EveTheWizard/Swarm-Drones/20190329_122631(2).jpg

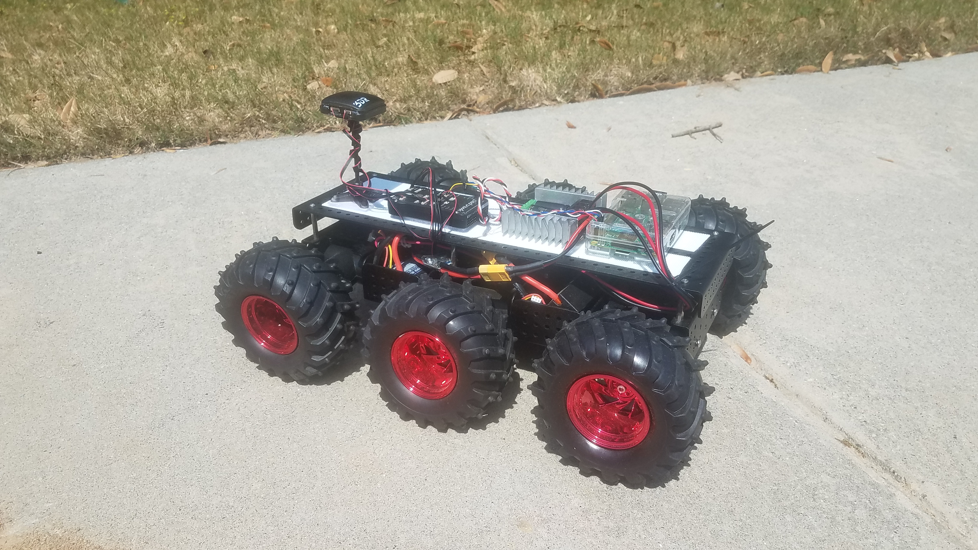
20190329_122631(2).jpg
