EveTheWizard/Swarm-Drones/20190407_185555.jpg

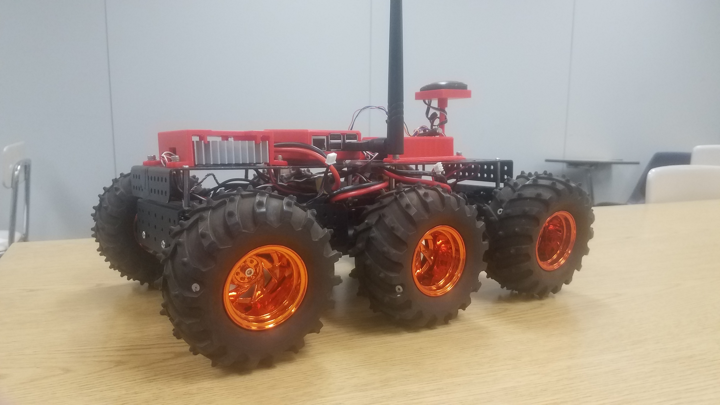
20190407_185555.jpg
