EveTheWizard/Swarm-Drones/README.md

# Swarm Drones
 A framework and prototype o a swarm drones system for controlling  a warm of land drones to go to a GPS location
