EveTheWizard/Swarm-Drones/Drawings/Circuit Diagram.docx

http://www.yolinux.com/TUTORIALS/images/Drones/Pixhawk-quadcopter-graphic-schematic.jpg
