EveTheWizard/Swarm-Drones/Drawings/Doc1.docx

Motor #2

Motor #4

Motor #6

Motor #5

Motor #3

Motor #1

On-Board CPU (Raspberry Pi 3)

Flight Controller (Pixhawk)

Power Module

Electronic Speed Controller and BEC

Switch

PPM Sum Receiver

Receiver

Transmitter

Li-Po Battery

Battery Sensor

GPS & Compass

Telemetry

Host Computer

Telemetry
