EveTheWizard/Swarm-Drones/CDR Presentation/Screenshot (2).png

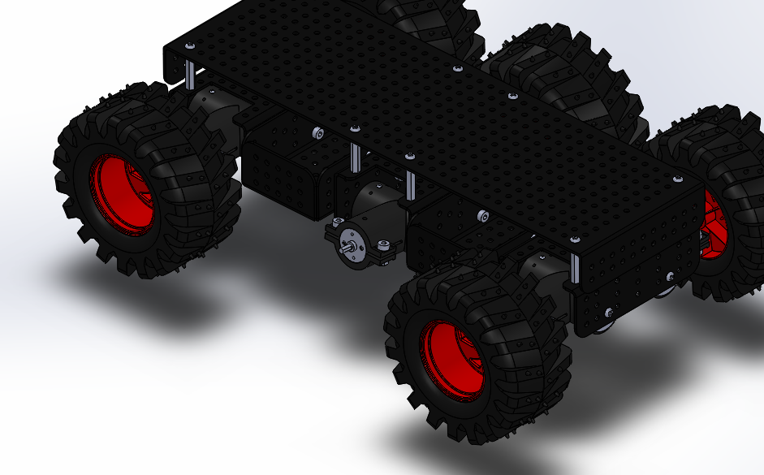
CDR Presentation/Screenshot (2).png
