EveTheWizard/Swarm-Drones/CDR Presentation/Screenshot (4).png

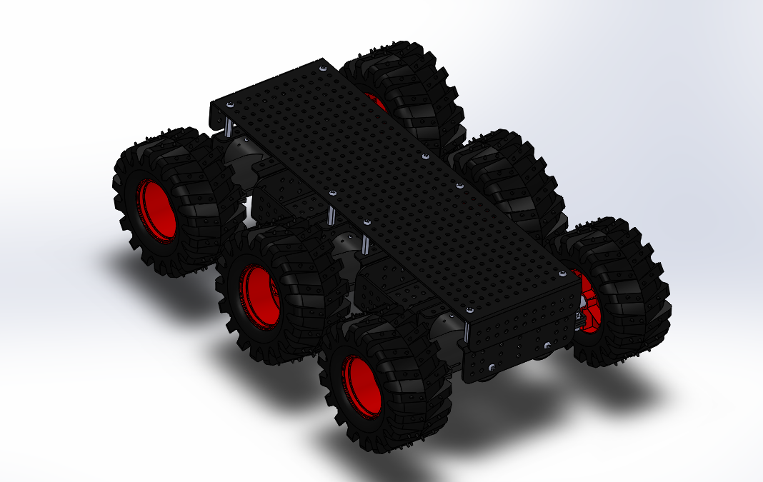
CDR Presentation/Screenshot (4).png
