EveTheWizard/Swarm-Drones/CDR Presentation/Screenshot (6).png

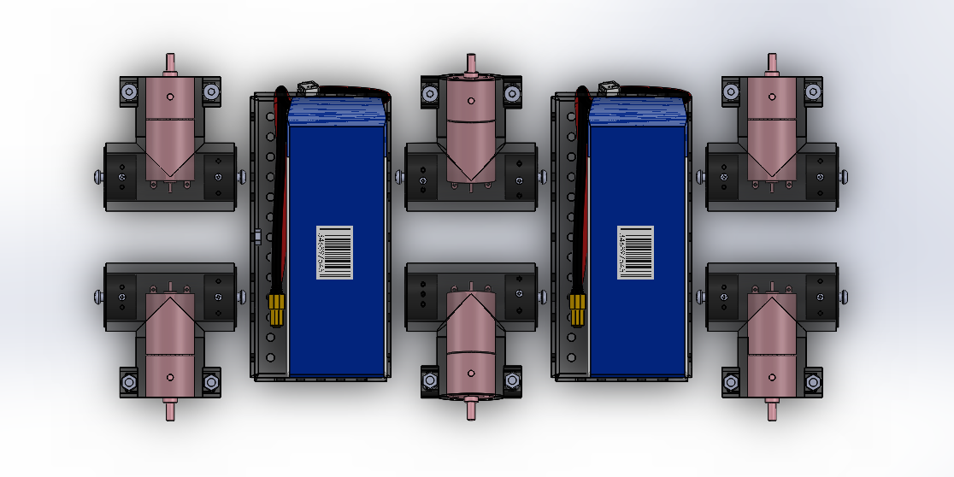
CDR Presentation/Screenshot (6).png
