EveTheWizard/Swarm-Drones/CDR Presentation/Screenshot (8).png

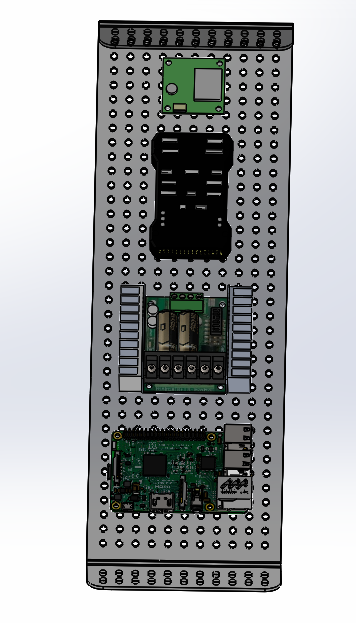
CDR Presentation/Screenshot (8).png
