EveTheWizard/Swarm-Drones/Map Data/Screenshot (1).png

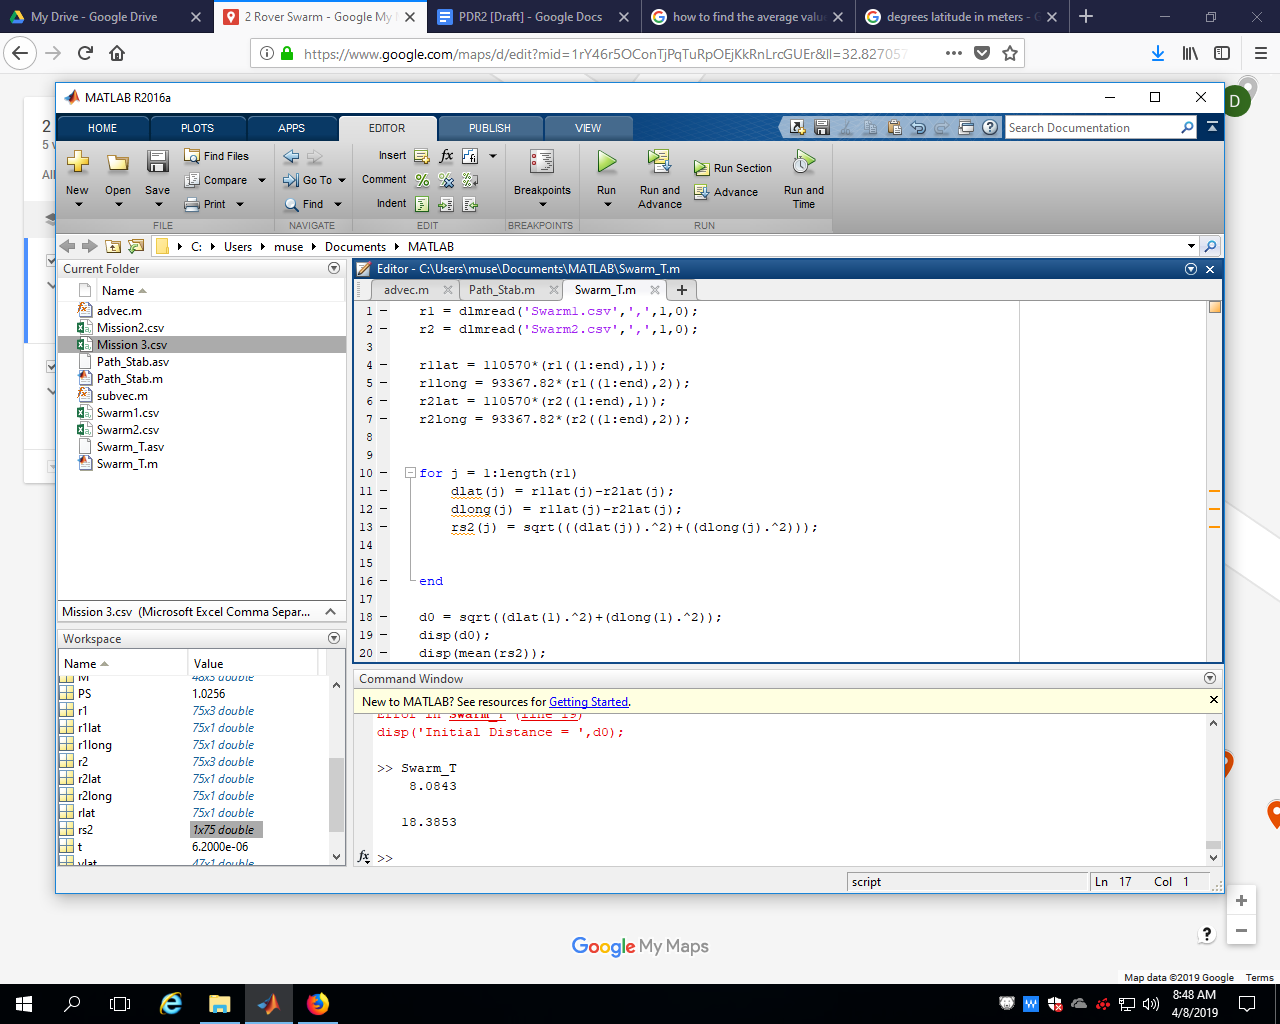
Map Data/Screenshot (1).png
