EveTheWizard/Swarm-Drones/Map Data/Screenshot (2).png

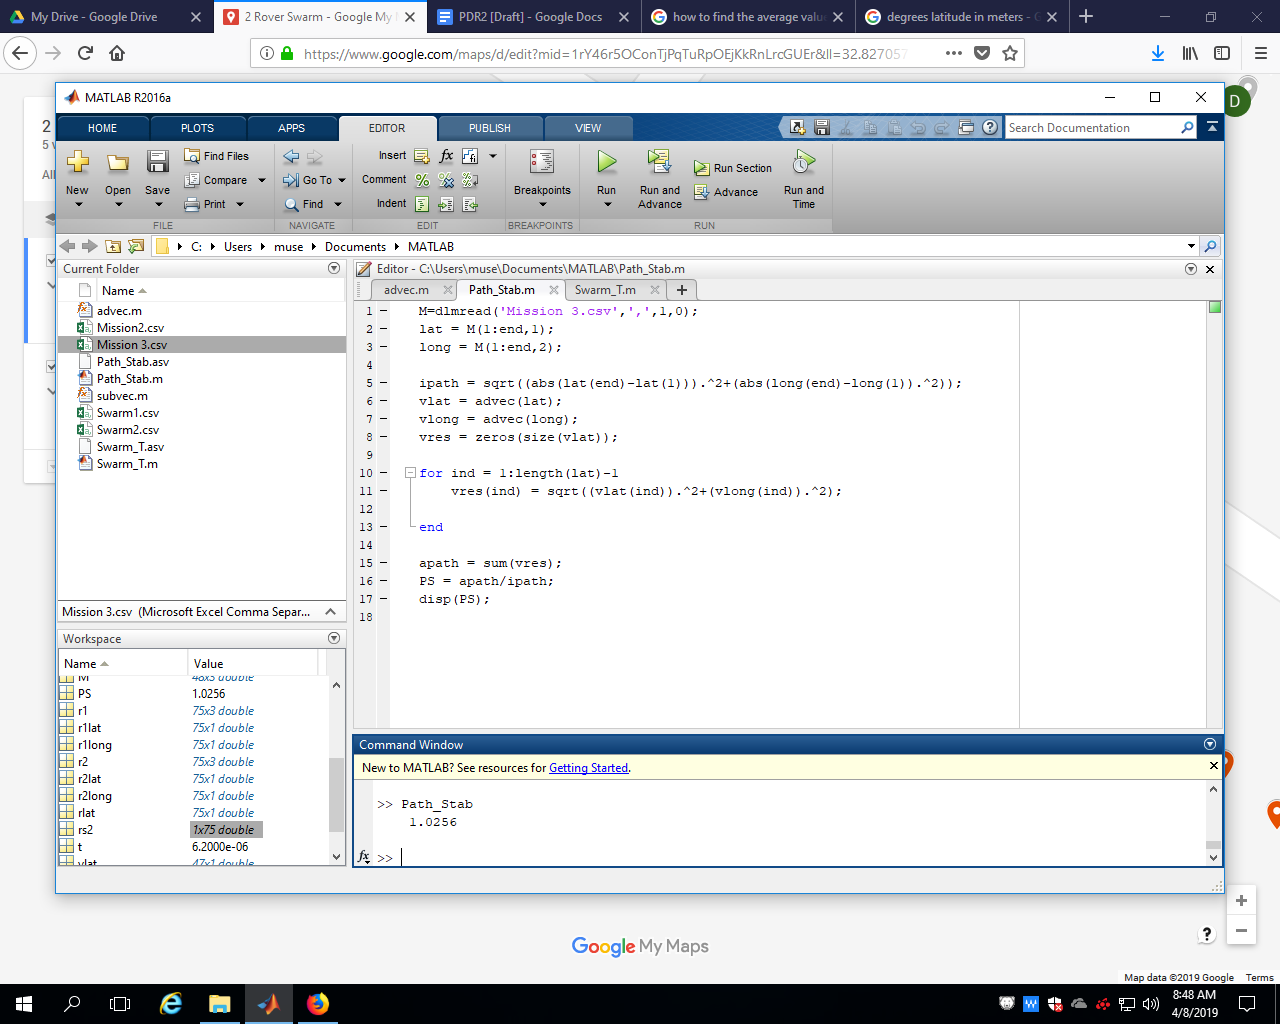
Map Data/Screenshot (2).png
