EveTheWizard/Swarm-Drones/Map Data/Screenshot (3).png

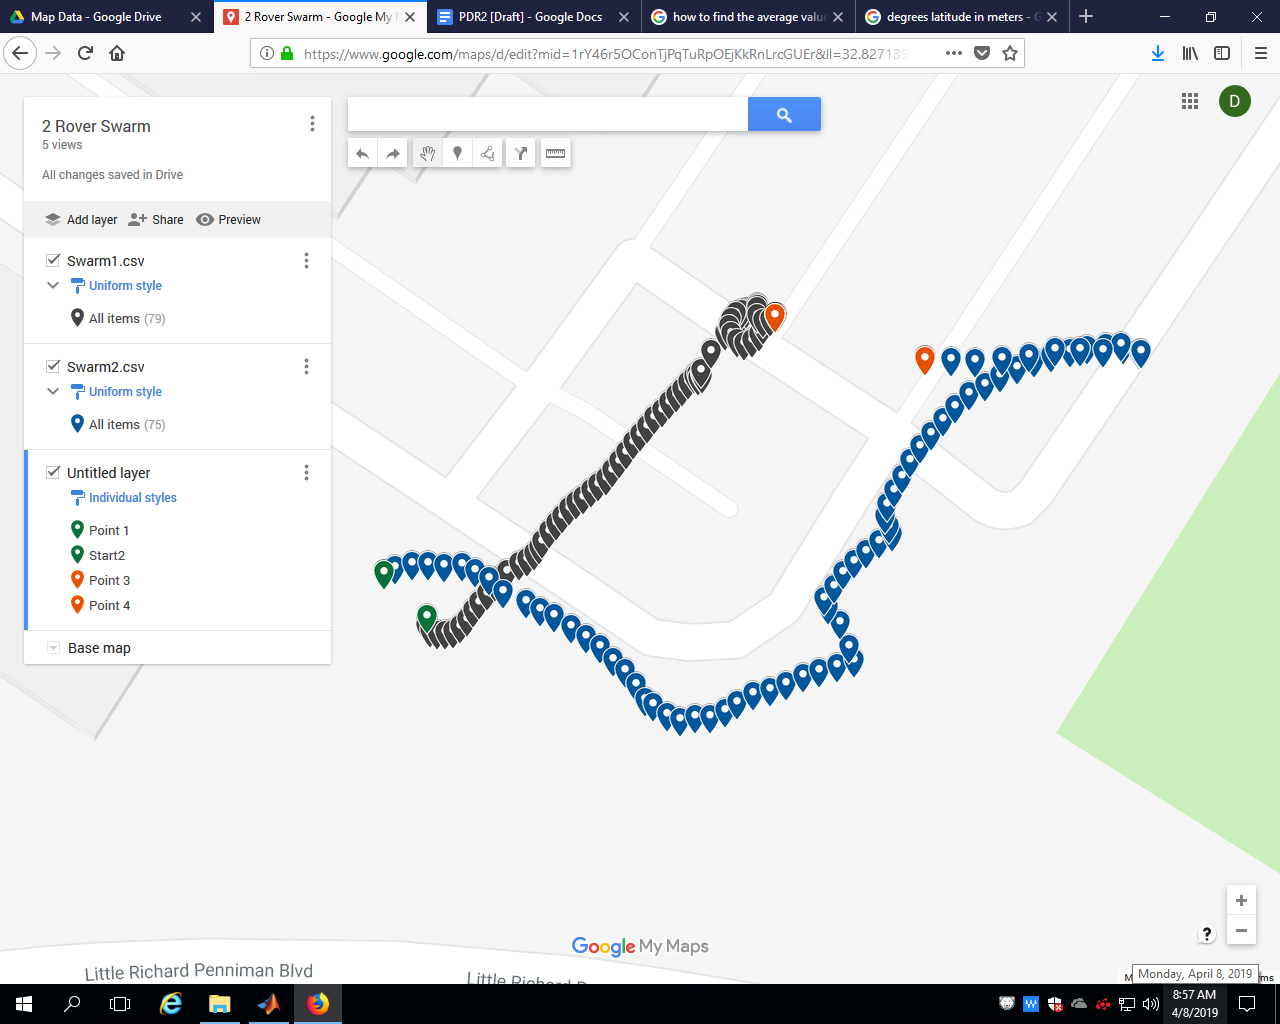
Map Data/Screenshot (3).png
