EveTheWizard/Swarm-Drones/Chassis SW/Whole THANG/motor_asm.SLDASM

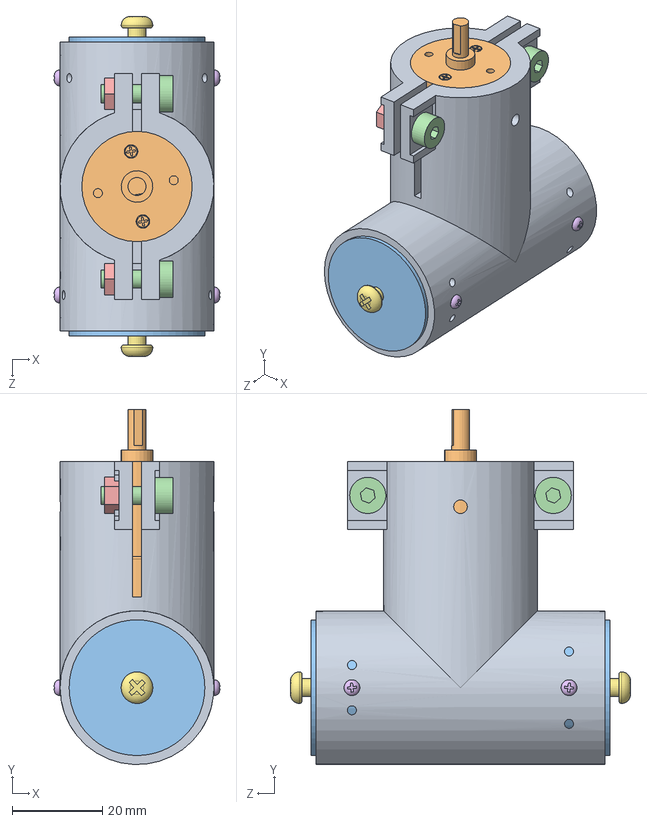
[picture p26: CAD file, 2021-12-29]
Chassis SW/Whole THANG/motor_asm.SLDASM
36.6 x 78.5 x 75.2 mm
motor_bracket
AL-GA25 - motor
motor_case_cover x 2
m4_12mm_allen x 2
m4_nut x 2
m2_6mm_screw x 4
m4_18mm_screw x 2
