EveTheWizard/Swarm-Drones/Drawings/Solidworks/Rough Assembly.SLDASM

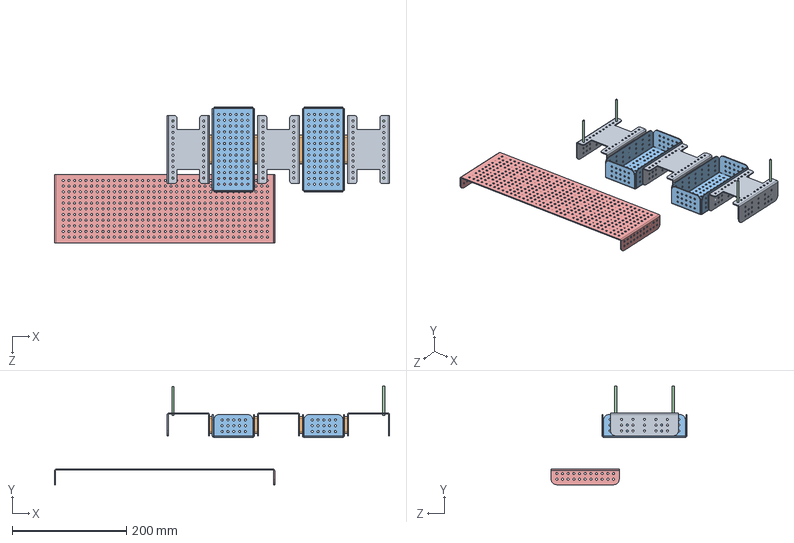
[picture p27: CAD file, 2021-12-29]
Drawings/Solidworks/Rough Assembly.SLDASM
585.2 x 172.2 x 237.2 mm
Motor Base Plate x 3
Chasis Spacer x 4
Battery Base Plate x 2
Place Holder x 4
Top Plate
