EveTheWizard/Swarm-Drones/Drawings/Solidworks/Rover Assembly.SLDASM

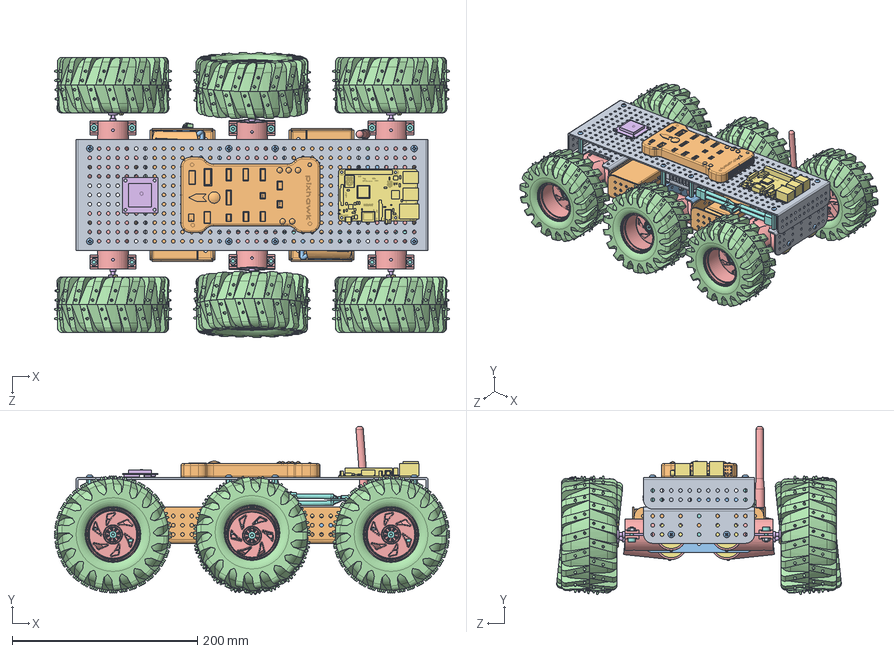
[picture p28: CAD file, 2021-12-29]
Drawings/Solidworks/Rover Assembly.SLDASM
426.2 x 181.8 x 307.3 mm
wheel_chassis_short x 2
small_chassis x 2
wheel_chassis_long
frame_connector x 4
motor_bracket x 6
AL-GA25 - motor x 6
motor_case_cover x 12
m4_12mm_allen x 26
m4_nut x 20
m2_6mm_screw x 24
m4_18mm_screw x 28
Tire x 6
tire_rim x 6
wheel_adapter x 6
m3_8mm_allen x 6
m4_28mm_distance x 8
top_chasis
Funda de la bateria x 2
Nucleo de la bateria x 2
Conector XT60 x 2
uBloxGPS
Rpi3Bplus
modulo_de_poder
Sabertooth 2x60
Pxhawk_Flight_Controller
baseTel
connector
antena
