EveTheWizard/Swarm-Drones/Chassis SW/right_wheel_asm.SLDASM

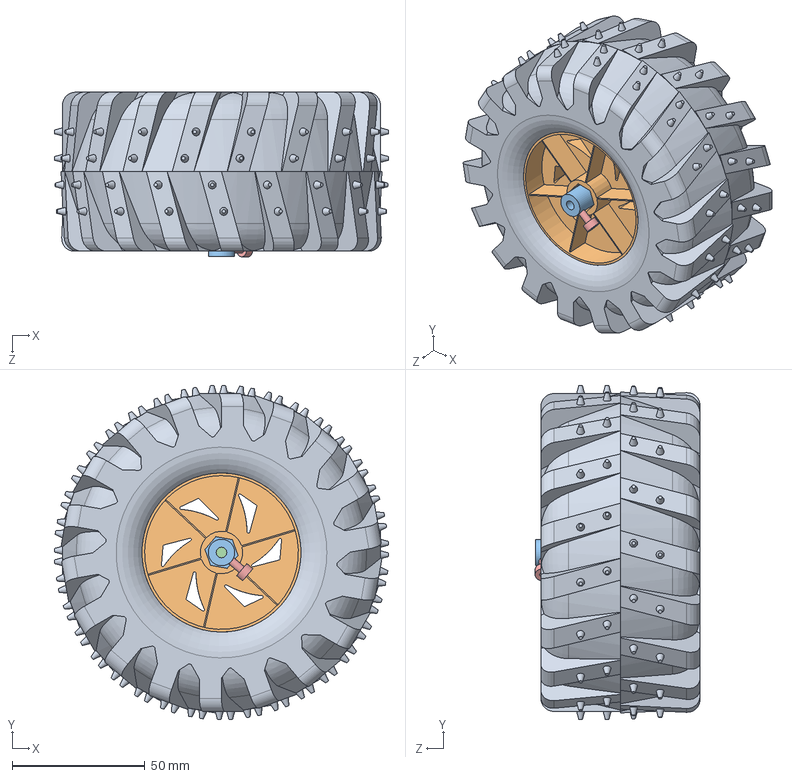
[picture p29: CAD file, 2021-12-29]
Chassis SW/right_wheel_asm.SLDASM
126.0 x 126.0 x 62.2 mm
Tire
tire_rim
wheel_adapter
m4_12mm_allen
m3_8mm_allen
