EveTheWizard/Swarm-Drones/Chassis SW/Whole THANG/ASM_MAIN_6WD.SLDASM

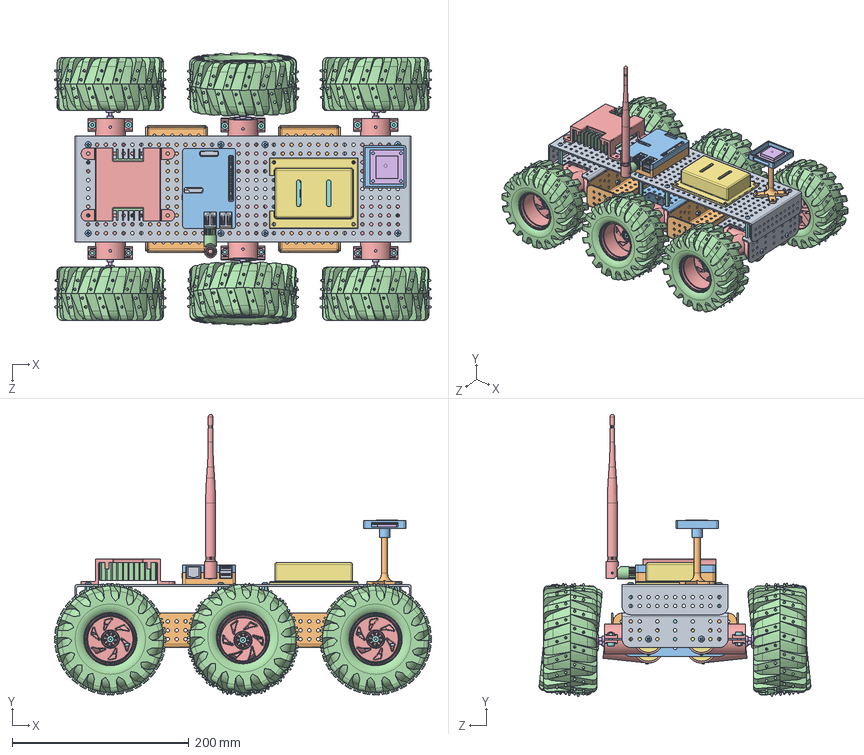
[picture p30: CAD file, 2021-12-29]
Chassis SW/Whole THANG/ASM_MAIN_6WD.SLDASM
426.2 x 319.1 x 307.3 mm
wheel_chassis_short x 2
small_chassis x 2
wheel_chassis_long
frame_connector x 4
motor_bracket x 6
AL-GA25 - motor x 6
motor_case_cover x 12
m4_12mm_allen x 26
m4_nut x 20
m2_6mm_screw x 24
m4_18mm_screw x 28
Tire x 6
tire_rim x 6
wheel_adapter x 6
m3_8mm_allen x 6
m4_28mm_distance x 8
top_chasis
3DR Stand
3DR Platform
Sabertooth2x25A
Sabertooth Housing
uBloxGPS
Pixhawk Housing
Pixhawk
Raspberry Pi Model B
Pi Case Bottom
Pi Case Top
Antenna hub
Antennae
