EveTheWizard/Swarm-Drones/Chassis SW/Bottom_SubAssembly.SLDASM

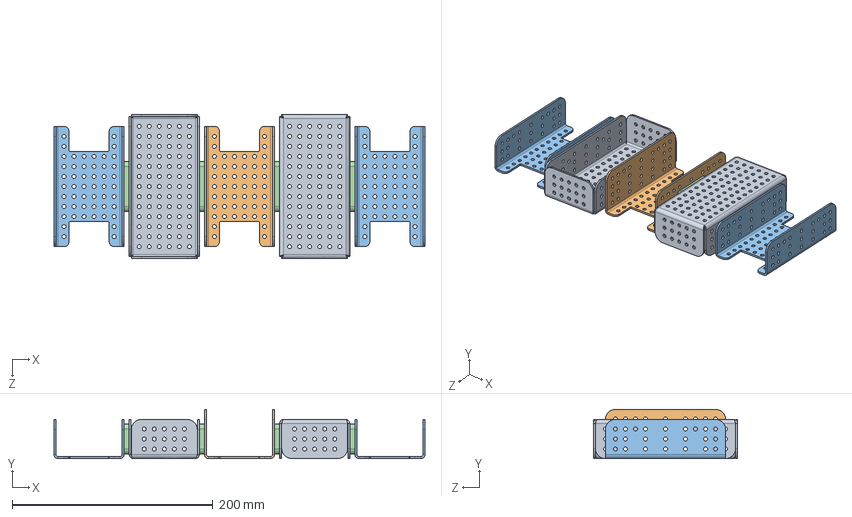
[picture p31: CAD file, 2021-12-29]
Chassis SW/Bottom_SubAssembly.SLDASM
370.0 x 49.0 x 144.0 mm
small_chassis x 2
wheel_chassis_long
wheel_chassis_short x 2
frame_connector x 4
