EveTheWizard/Swarm-Drones/Bumper#1.stl

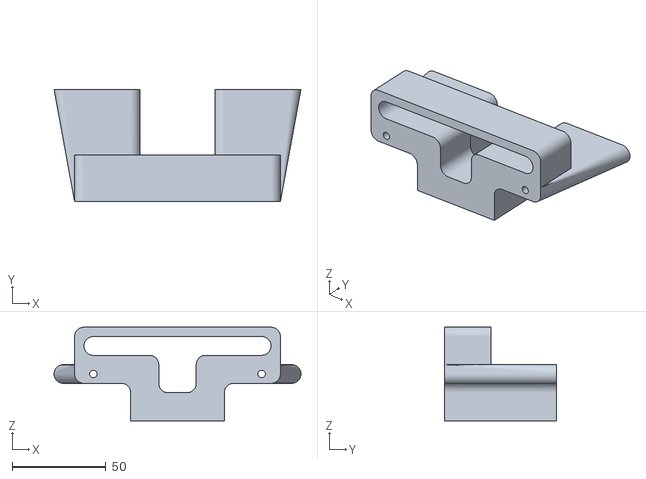
[picture p32: CAD file, 2021-12-29]
Bumper#1.stl
132.0 x 60.0 x 50.0
