EveTheWizard/Swarm-Drones/Chassis SW/Whole THANG/Pixhawk.SLDPRT

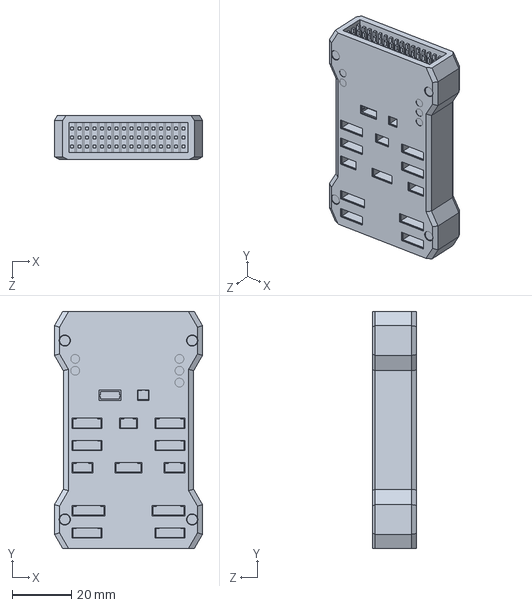
[picture p33: CAD file, 2021-12-29]
Chassis SW/Whole THANG/Pixhawk.SLDPRT
50.0 x 80.0 x 15.0 mm
