EveTheWizard/Swarm-Drones/Drawings/Sabertooth Housing.SLDPRT

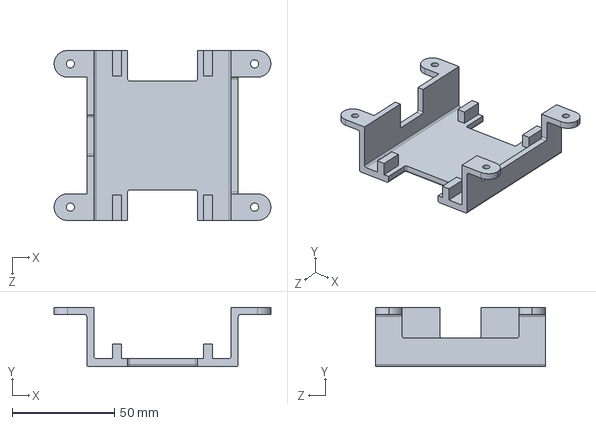
[picture p34: CAD file, 2021-12-29]
Drawings/Sabertooth Housing.SLDPRT
106.0 x 29.0 x 83.0 mm
