EveTheWizard/Swarm-Drones/Drawings/Solidworks/Motor Housing (Half).SLDPRT

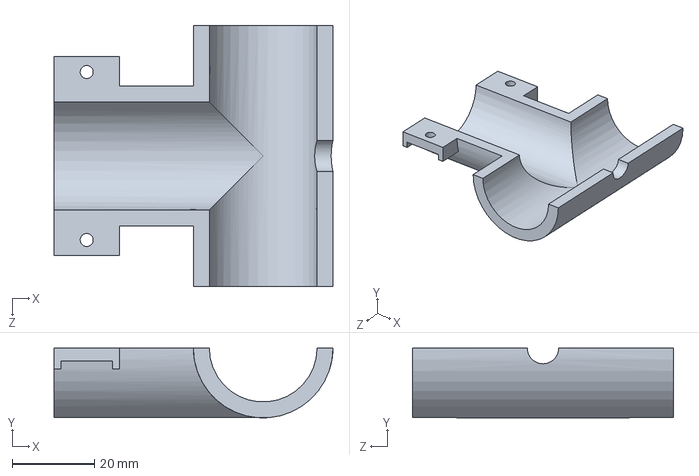
[picture p35: CAD file, 2021-12-29]
Drawings/Solidworks/Motor Housing (Half).SLDPRT
67.8 x 17.0 x 63.5 mm
