EveTheWizard/Swarm-Drones/Prints/RasperryPi_2_Case_magnetic.stl

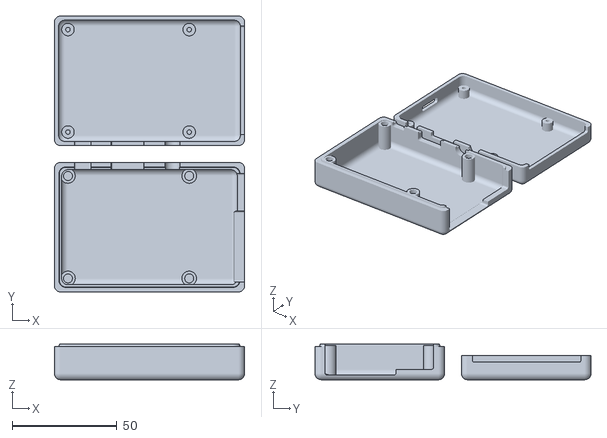
[picture p36: CAD file, 2021-12-29]
Prints/RasperryPi_2_Case_magnetic.stl
91.0 x 132.0 x 17.0
