EveTheWizard/Swarm-Drones/Chassis SW/top_chasis.SLDPRT

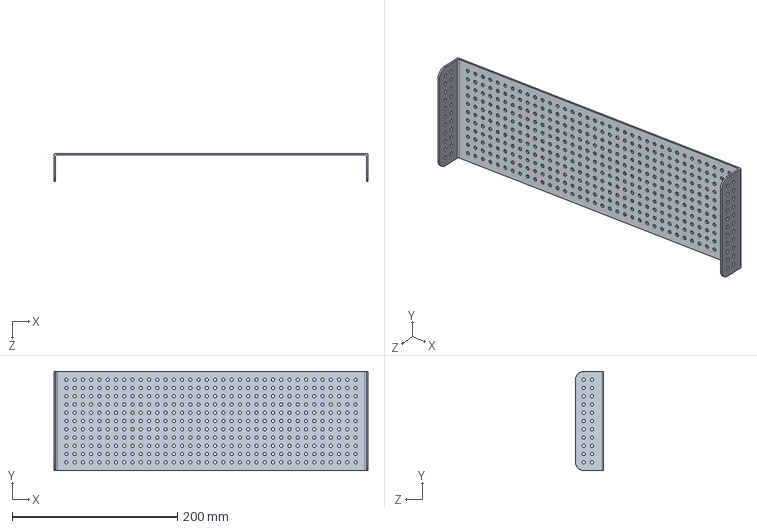
[picture p37: CAD file, 2021-12-29]
Chassis SW/top_chasis.SLDPRT
380.0 x 120.0 x 34.0 mm
