EveTheWizard/Swarm-Drones/Chassis SW/Whole THANG/wheel_chassis_long.SLDPRT

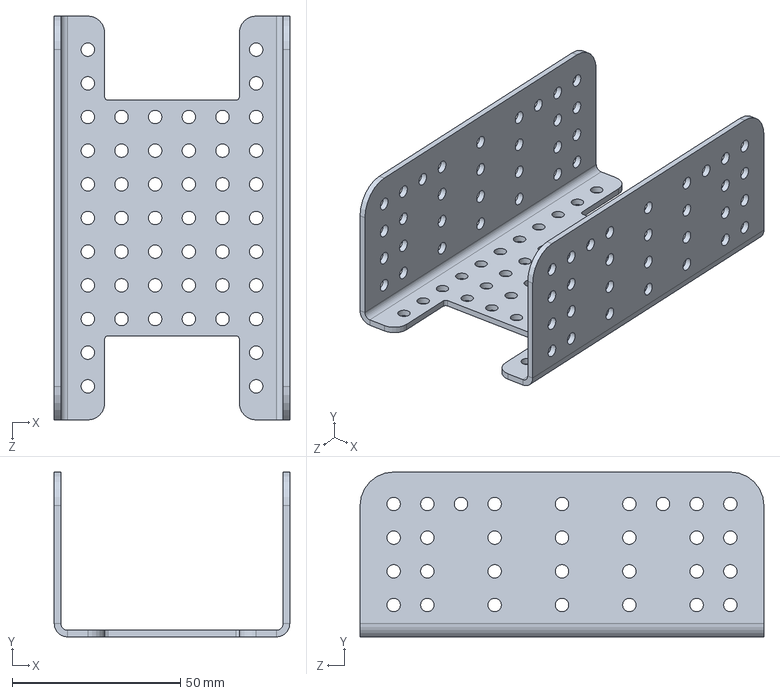
[picture p38: CAD file, 2021-12-29]
Chassis SW/Whole THANG/wheel_chassis_long.SLDPRT
70.0 x 49.0 x 120.0 mm
