EveTheWizard/Swarm-Drones/Drawings/Saddle_Bracket.STL

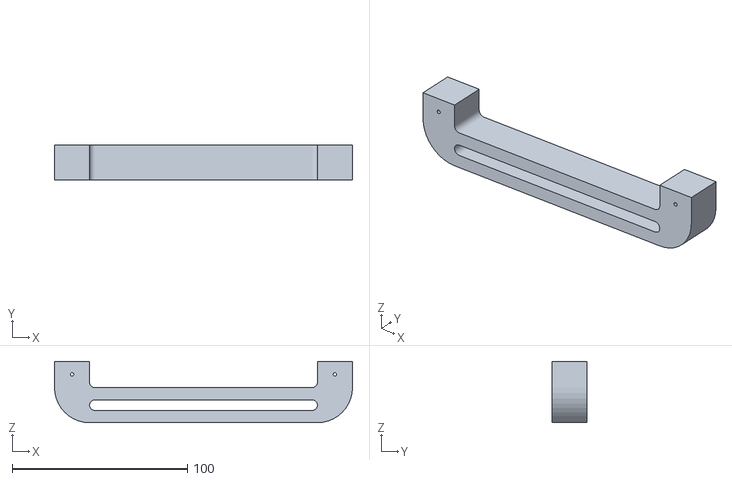
[picture p39: CAD file, 2021-12-29]
Drawings/Saddle_Bracket.STL
170.0 x 20.0 x 35.0
