EveTheWizard/Swarm-Drones/Drawings/Solidworks/Motor Base Plate.SLDPRT

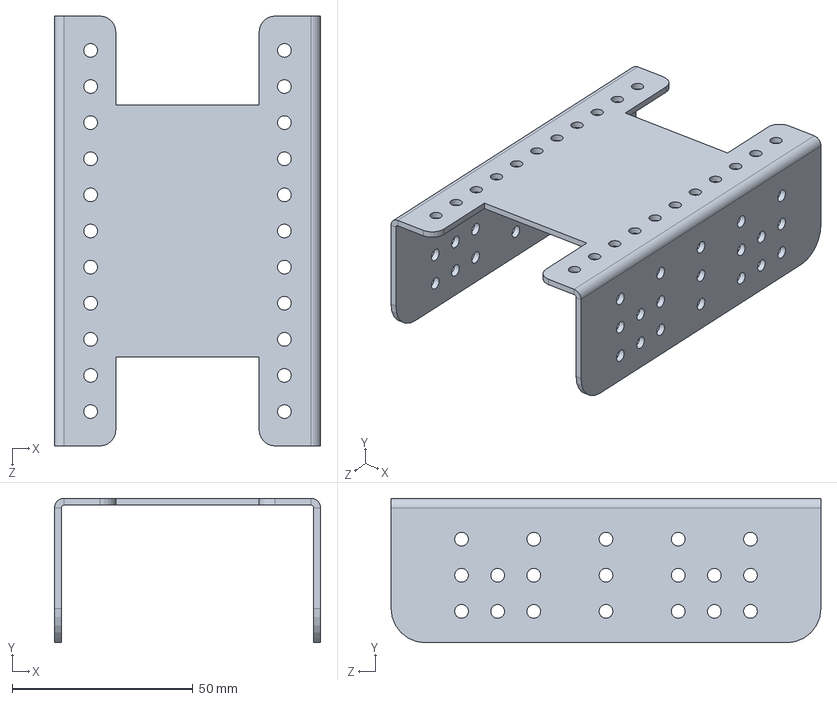
[picture p40: CAD file, 2021-12-29]
Drawings/Solidworks/Motor Base Plate.SLDPRT
73.7 x 40.0 x 119.1 mm
