EveTheWizard/Swarm-Drones/Chassis SW/wheel_adapter.SLDPRT

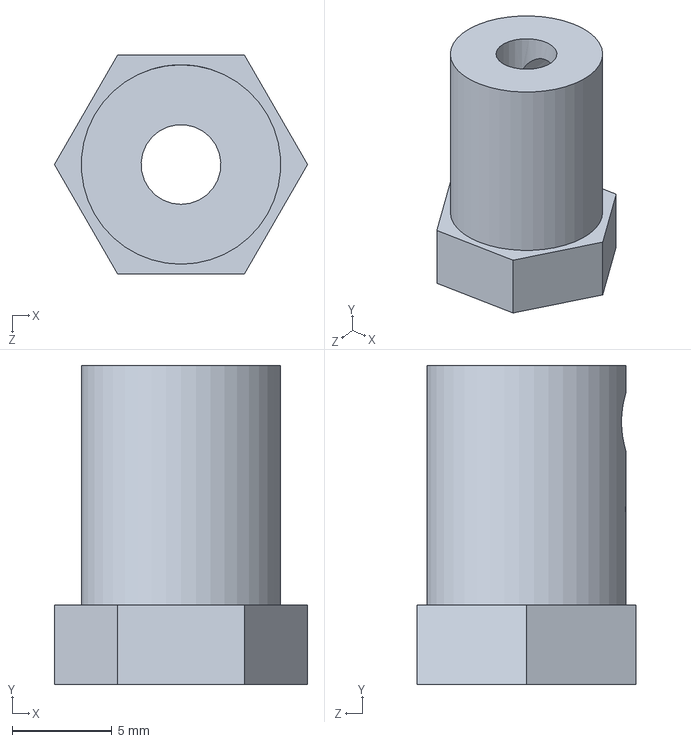
[picture p41: CAD file, 2021-12-29]
Chassis SW/wheel_adapter.SLDPRT
12.7 x 16.0 x 11.0 mm
