EveTheWizard/Swarm-Drones/Chassis SW/Whole THANG/frame_connector.SLDPRT

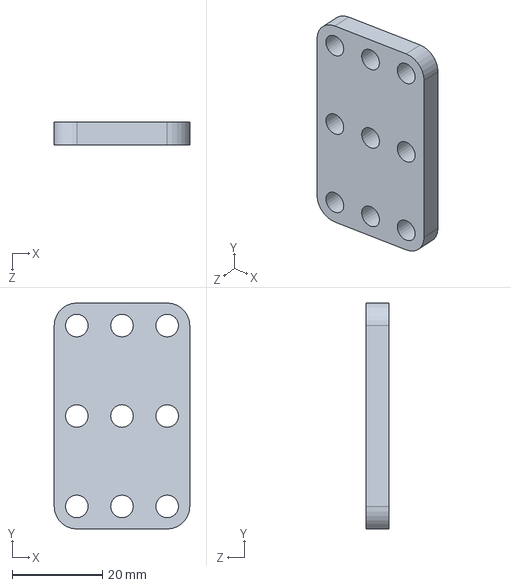
[picture p42: CAD file, 2021-12-29]
Chassis SW/Whole THANG/frame_connector.SLDPRT
30.0 x 50.0 x 5.00 mm
