EveTheWizard/Swarm-Drones/Drawings/Solidworks/Place Holder.SLDPRT

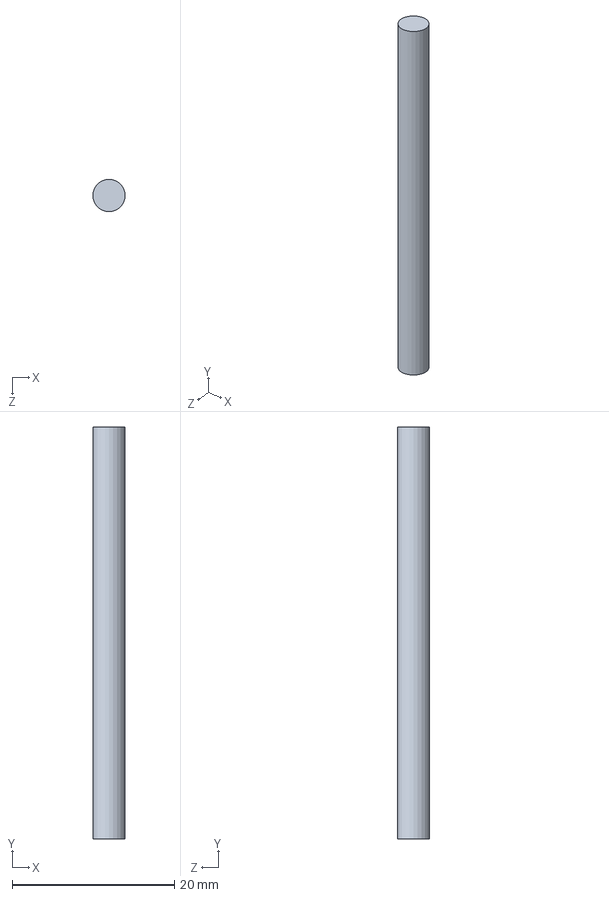
[picture p43: CAD file, 2021-12-29]
Drawings/Solidworks/Place Holder.SLDPRT
4.00 x 50.8 x 4.00 mm
