EveTheWizard/Swarm-Drones/Prints/3DR Stand.SLDPRT

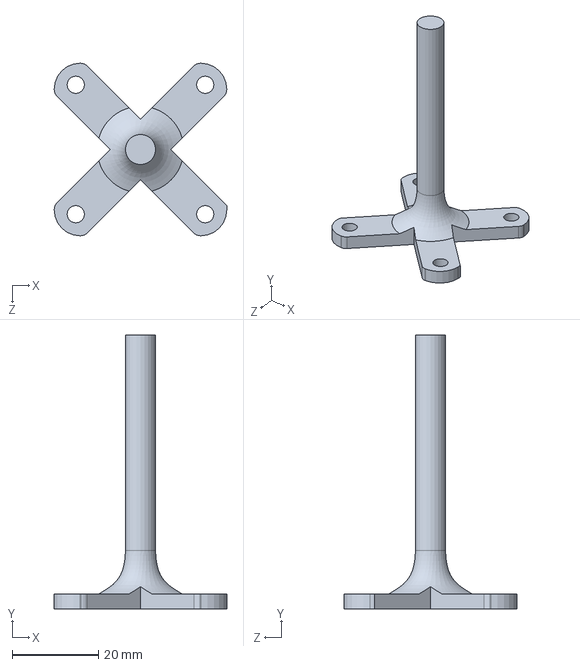
[picture p44: CAD file, 2021-12-29]
Prints/3DR Stand.SLDPRT
40.0 x 63.5 x 40.0 mm
