EveTheWizard/Swarm-Drones/Chassis SW/motor_bracket.SLDPRT

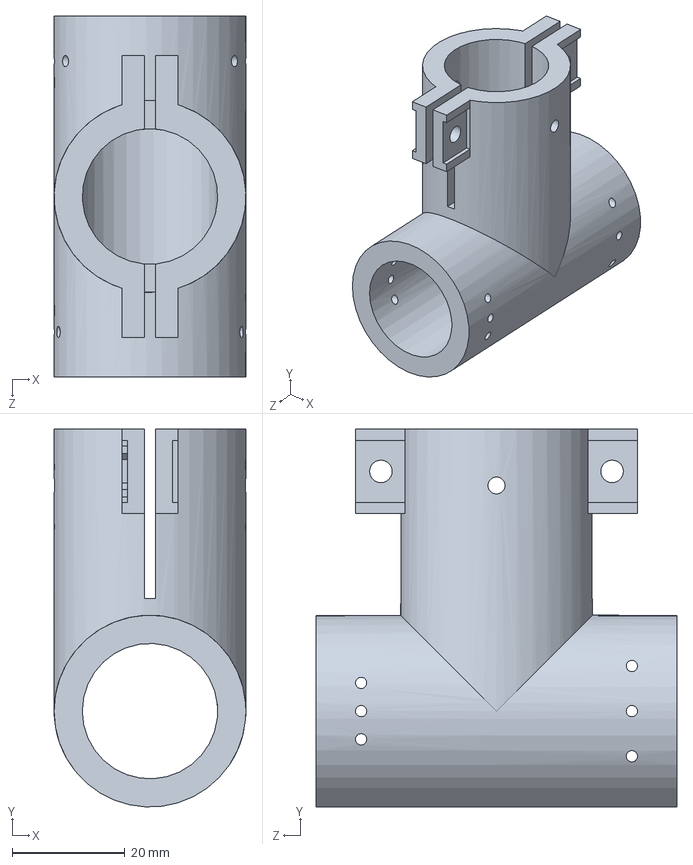
[picture p45: CAD file, 2021-12-29]
Chassis SW/motor_bracket.SLDPRT
34.0 x 67.0 x 64.0 mm
