EveTheWizard/Swarm-Drones/Drawings/Solidworks/Motor Housing Male.SLDPRT

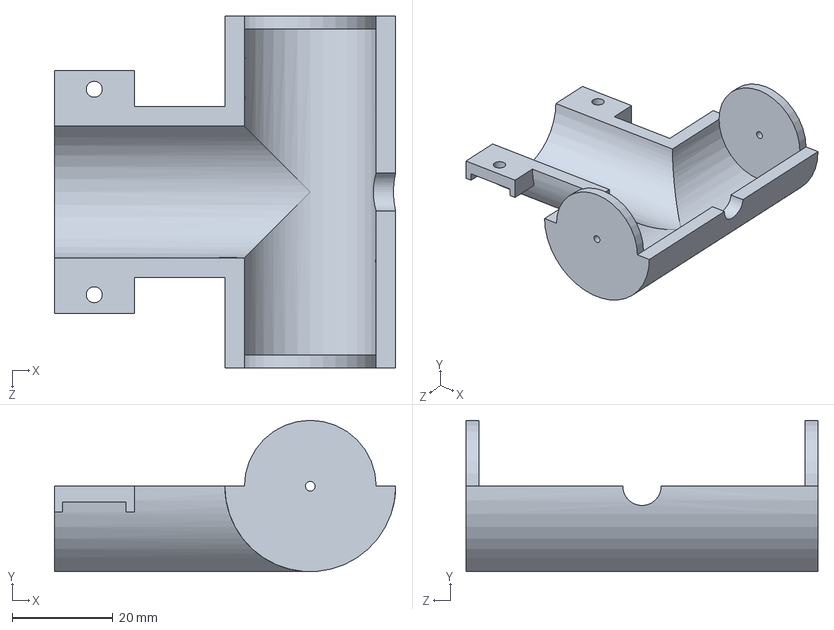
[picture p46: CAD file, 2021-12-29]
Drawings/Solidworks/Motor Housing Male.SLDPRT
67.8 x 30.0 x 69.8 mm
