EveTheWizard/Swarm-Drones/Prints/Pixhawk Housing.SLDPRT

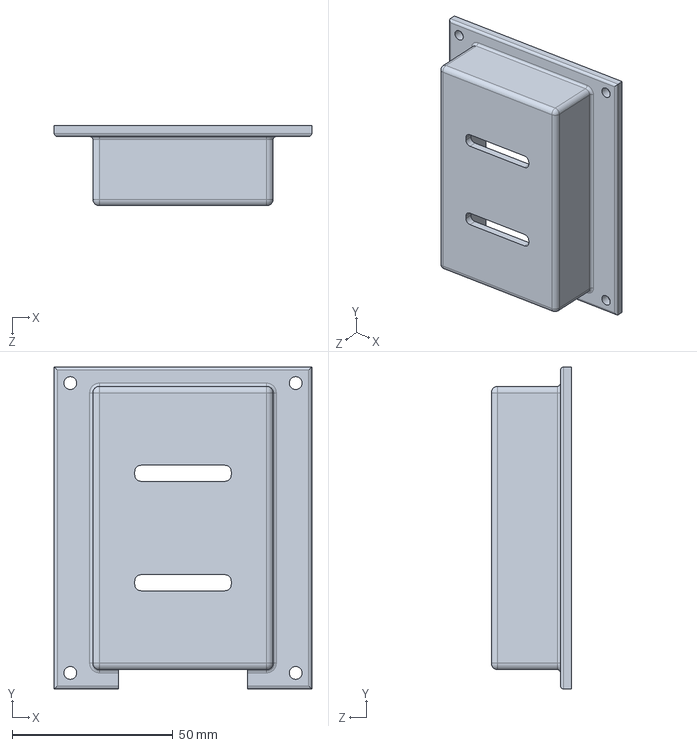
[picture p47: CAD file, 2021-12-29]
Prints/Pixhawk Housing.SLDPRT
80.0 x 100.0 x 25.0 mm
