EveTheWizard/Swarm-Drones/Chassis SW/Whole THANG/Pi Case Bottom.SLDPRT

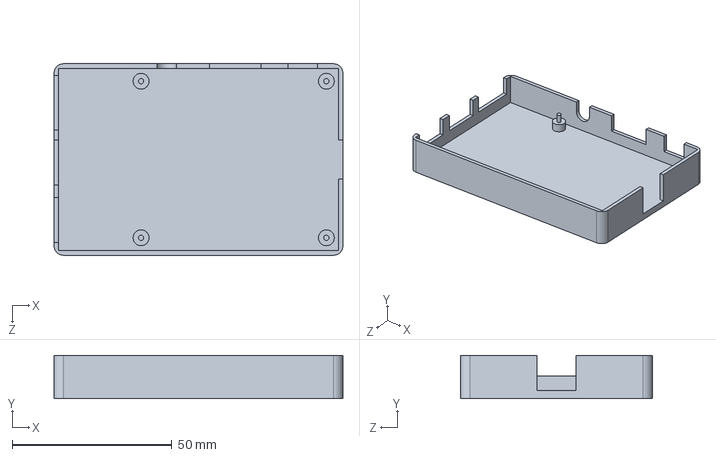
[picture p48: CAD file, 2021-12-29]
Chassis SW/Whole THANG/Pi Case Bottom.SLDPRT
90.4 x 13.6 x 60.0 mm
