EveTheWizard/Swarm-Drones/Prints/Pixhawk Housing - Copy.STL

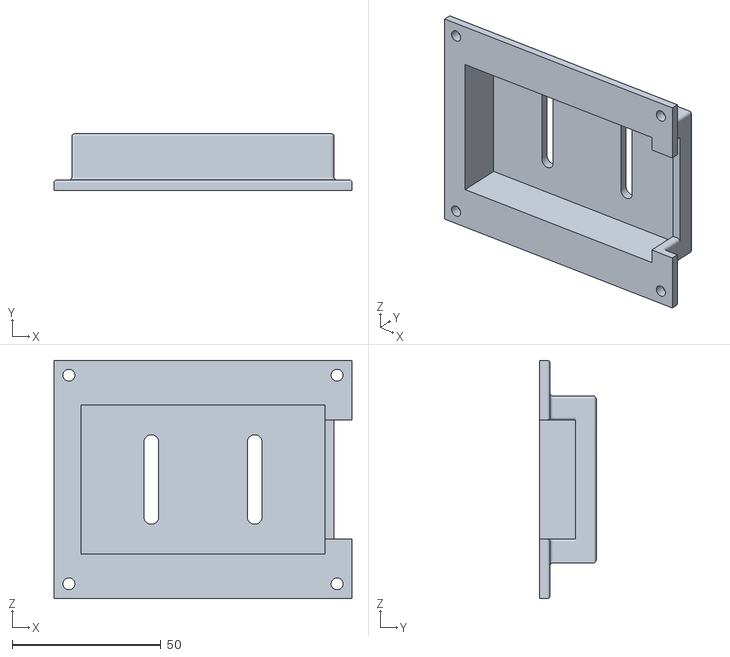
[picture p49: CAD file, 2021-12-29]
Prints/Pixhawk Housing - Copy.STL
100.0 x 19.0 x 80.0
