EveTheWizard/Swarm-Drones/Chassis SW/Whole THANG/Pi Case Top.SLDPRT

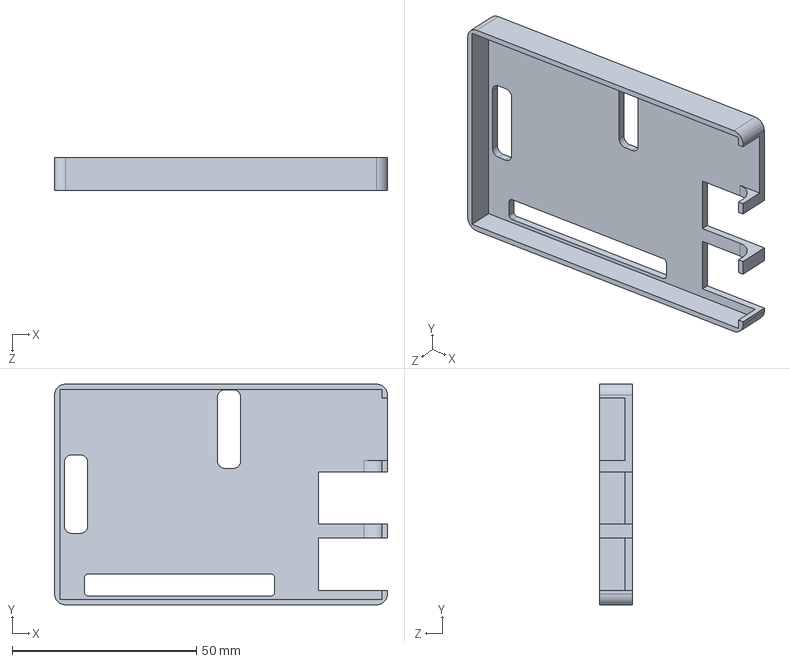
[picture p50: CAD file, 2021-12-29]
Chassis SW/Whole THANG/Pi Case Top.SLDPRT
90.4 x 60.0 x 9.00 mm
