EveTheWizard/Swarm-Drones/Drawings/Solidworks/Motor Housing Female.SLDPRT

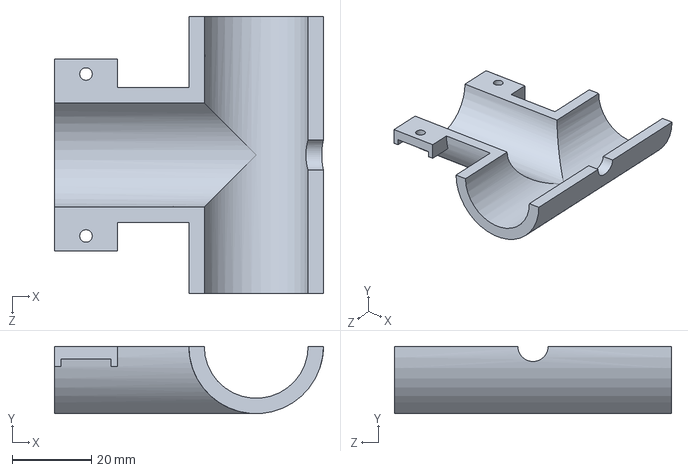
[picture p51: CAD file, 2021-12-29]
Drawings/Solidworks/Motor Housing Female.SLDPRT
67.8 x 17.0 x 69.8 mm
