EveTheWizard/Swarm-Drones/Prints/3DR Platform.SLDPRT

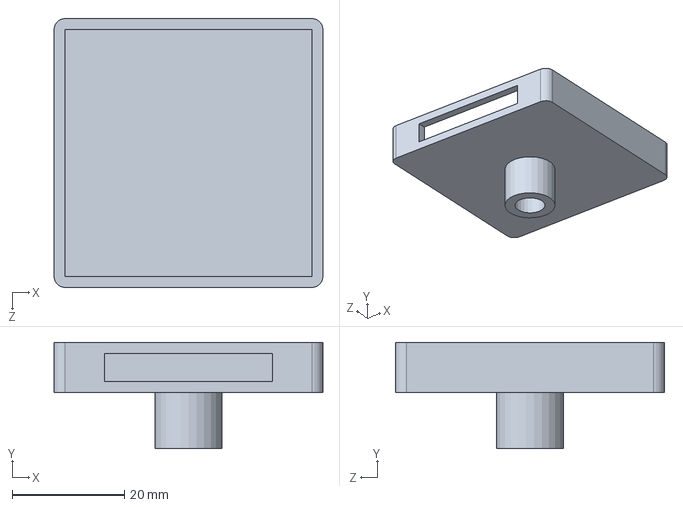
[picture p52: CAD file, 2021-12-29]
Prints/3DR Platform.SLDPRT
48.0 x 19.0 x 48.0 mm
