EveTheWizard/Swarm-Drones/Chassis SW/AL-GA25 - motor.SLDPRT

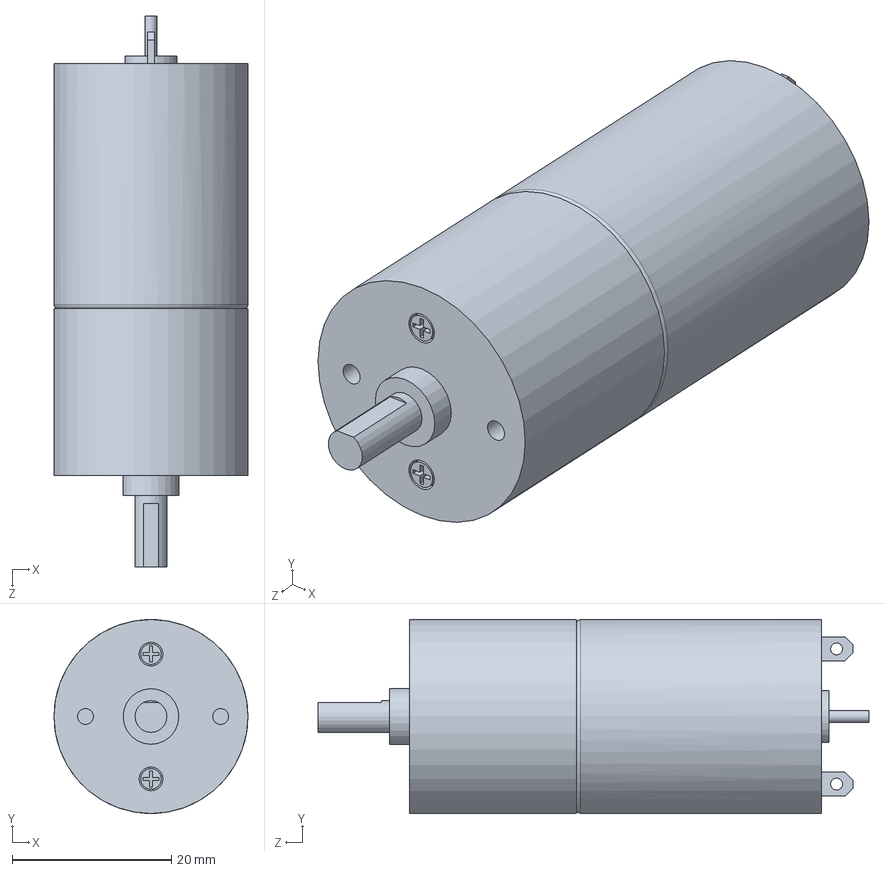
[picture p53: CAD file, 2021-12-29]
Chassis SW/AL-GA25 - motor.SLDPRT
24.4 x 24.4 x 69.3 mm
