EveTheWizard/Swarm-Drones/Chassis SW/Whole THANG/wheel_chassis_short.SLDPRT

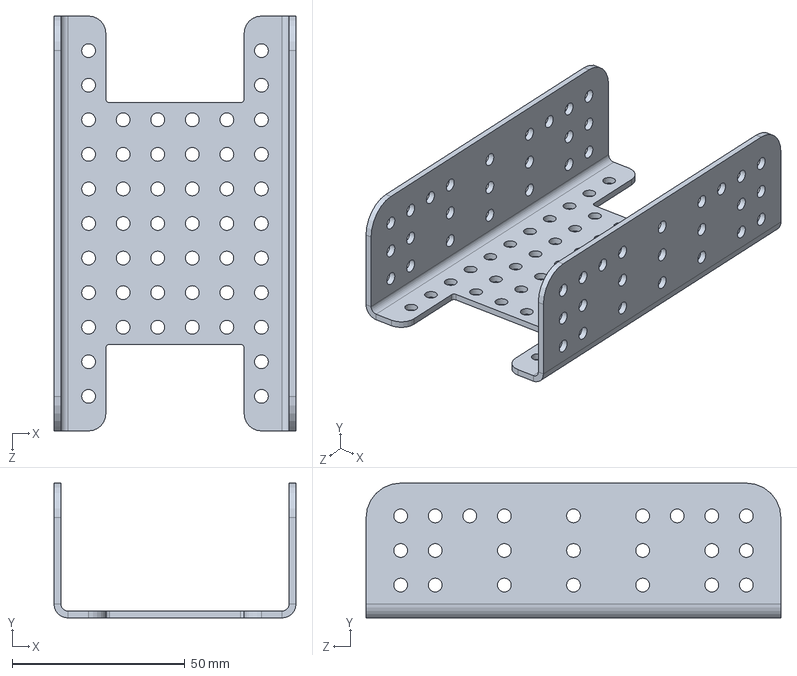
[picture p54: CAD file, 2021-12-29]
Chassis SW/Whole THANG/wheel_chassis_short.SLDPRT
70.0 x 39.0 x 120.0 mm
