EveTheWizard/Swarm-Drones/Drawings/Solidworks/Top Plate.SLDPRT

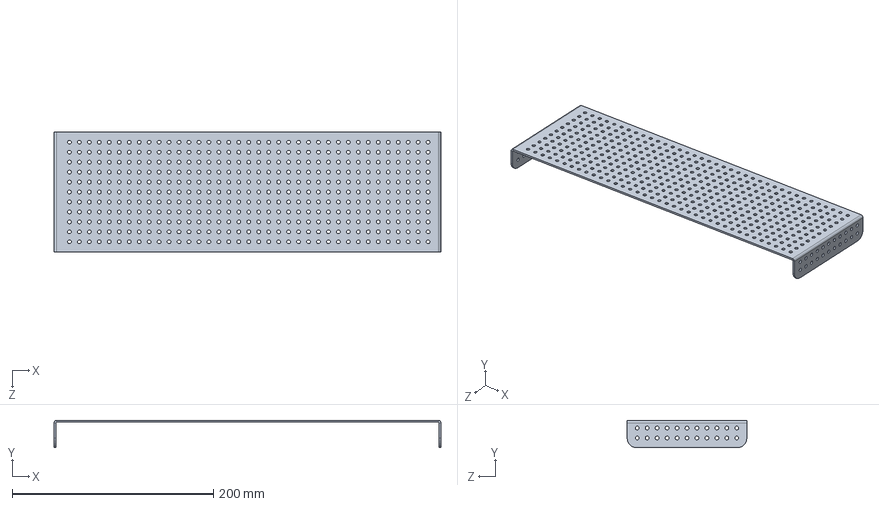
[picture p55: CAD file, 2021-12-29]
Drawings/Solidworks/Top Plate.SLDPRT
384.8 x 27.3 x 119.1 mm
