EveTheWizard/Swarm-Drones/Drawings/Solidworks/BUMPER.SLDPRT

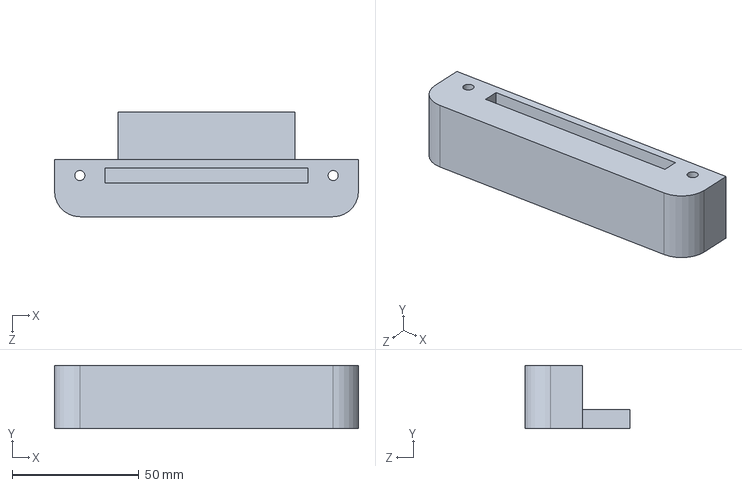
[picture p56: CAD file, 2021-12-29]
Drawings/Solidworks/BUMPER.SLDPRT
120.0 x 25.0 x 41.2 mm
