EveTheWizard/Swarm-Drones/Drawings/Solidworks/Battery Base Plate.SLDPRT

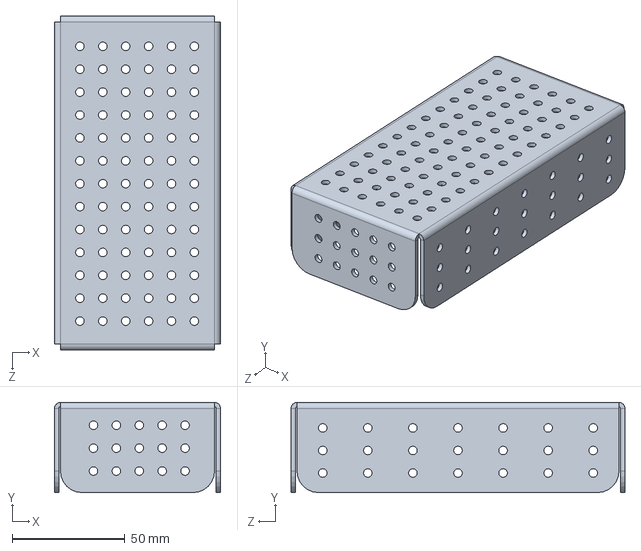
[picture p57: CAD file, 2021-12-29]
Drawings/Solidworks/Battery Base Plate.SLDPRT
73.7 x 40.0 x 148.2 mm
