EveTheWizard/Swarm-Drones/Chassis SW/motor_case_cover.SLDPRT

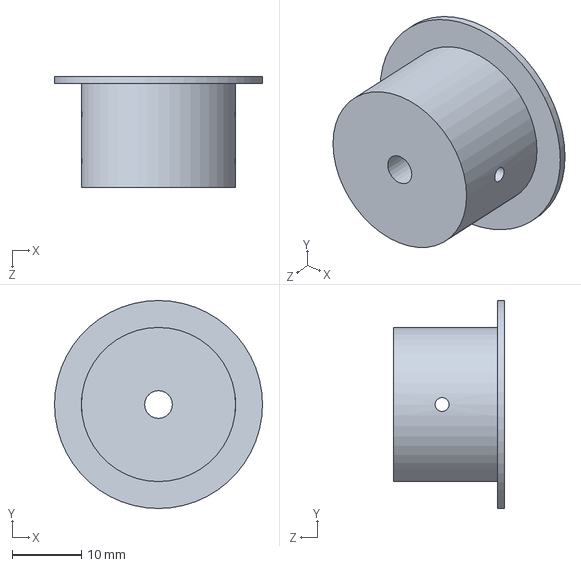
[picture p58: CAD file, 2021-12-29]
Chassis SW/motor_case_cover.SLDPRT
30.0 x 30.0 x 16.0 mm
