EveTheWizard/Swarm-Drones/Chassis SW/Whole THANG/Antennae.SLDPRT

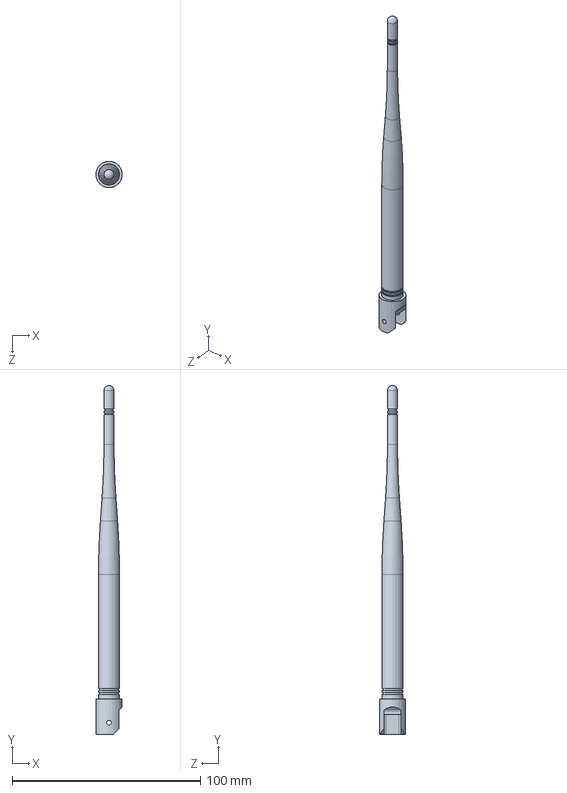
[picture p59: CAD file, 2021-12-29]
Chassis SW/Whole THANG/Antennae.SLDPRT
14.0 x 185.5 x 14.0 mm
