EveTheWizard/Swarm-Drones/Chassis SW/small_chassis.SLDPRT

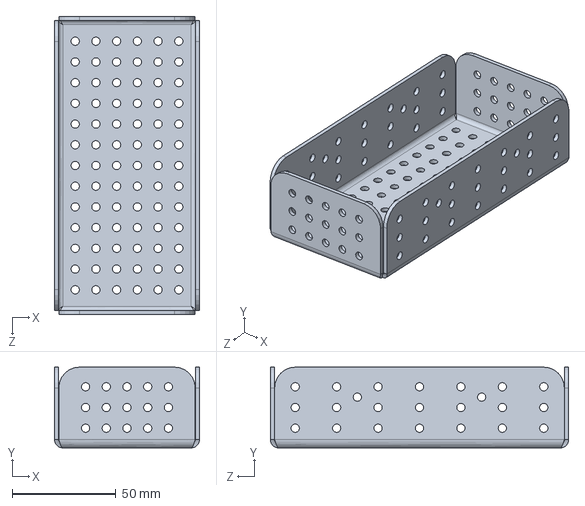
[picture p60: CAD file, 2021-12-29]
Chassis SW/small_chassis.SLDPRT
70.0 x 39.0 x 144.0 mm
