EveTheWizard/Swarm-Drones/Chassis SW/Whole THANG/uBloxGPS.SLDPRT

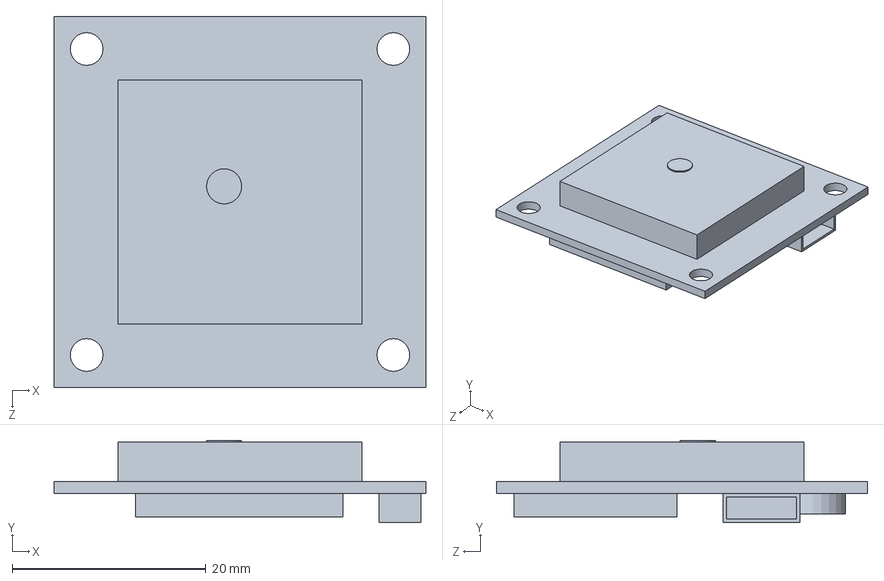
[picture p61: CAD file, 2021-12-29]
Chassis SW/Whole THANG/uBloxGPS.SLDPRT
38.4 x 8.48 x 38.3 mm
