EveTheWizard/Swarm-Drones/Chassis SW/Tire.SLDPRT

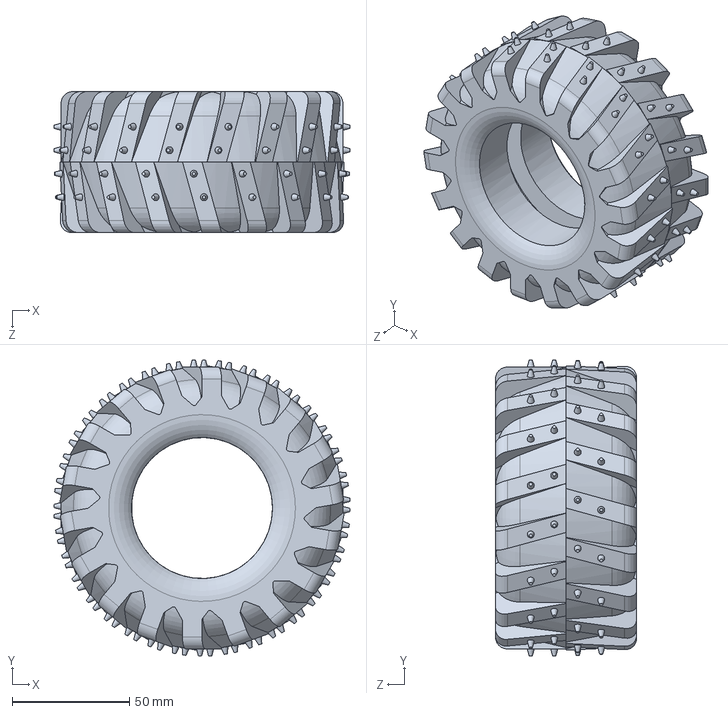
[picture p62: CAD file, 2021-12-29]
Chassis SW/Tire.SLDPRT
126.0 x 126.0 x 60.0 mm
