EveTheWizard/Swarm-Drones/Chassis SW/tire_rim.SLDPRT

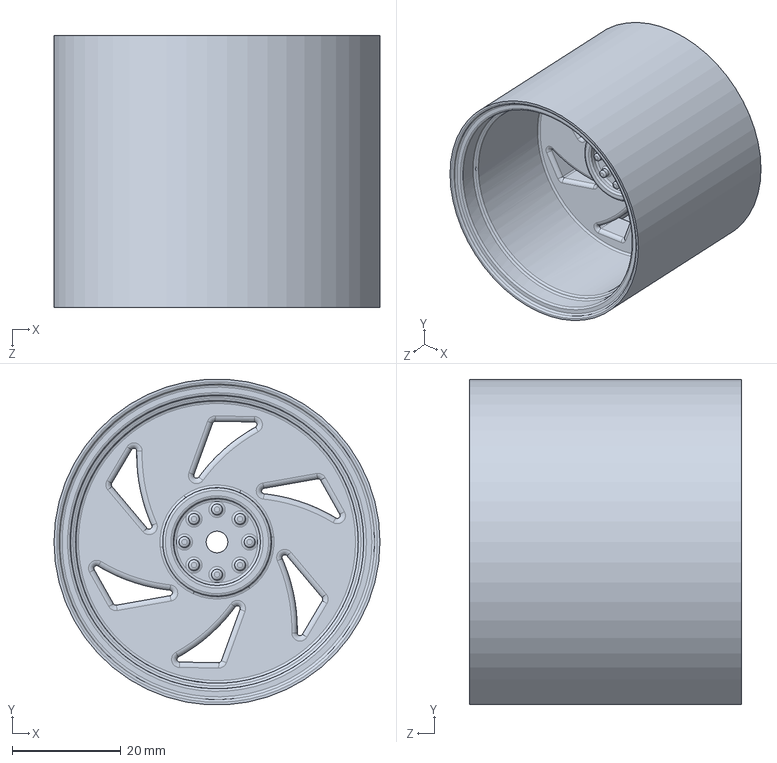
[picture p63: CAD file, 2021-12-29]
Chassis SW/tire_rim.SLDPRT
60.0 x 59.9 x 50.0 mm
