EveTheWizard/Swarm-Drones/Chassis SW/Whole THANG/Antenna hub.SLDPRT

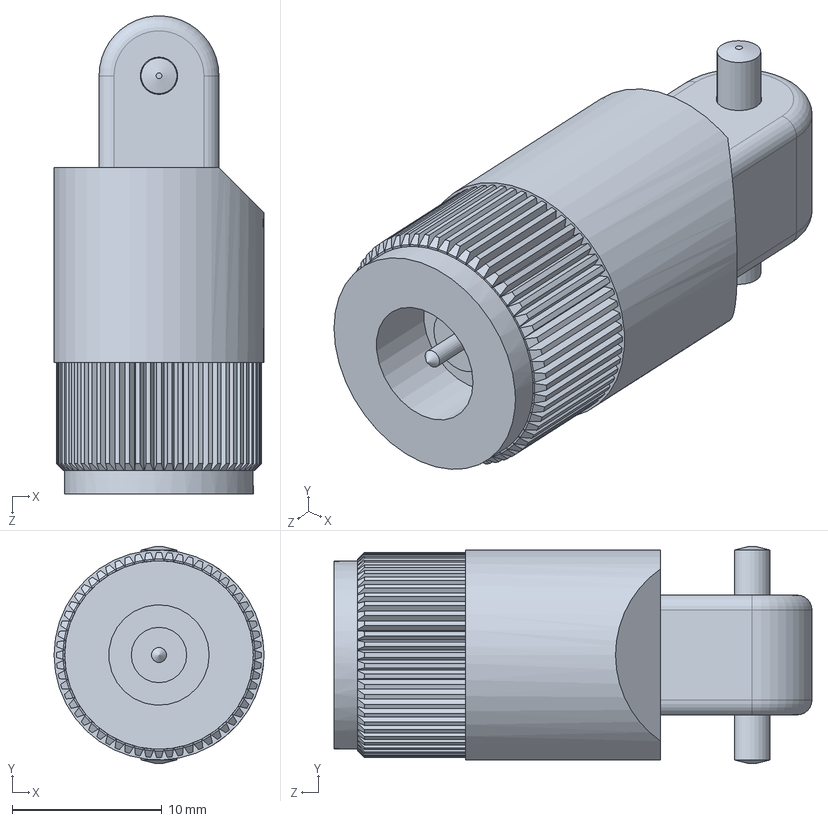
[picture p64: CAD file, 2021-12-29]
Chassis SW/Whole THANG/Antenna hub.SLDPRT
14.0 x 14.5 x 31.9 mm
