EveTheWizard/Swarm-Drones/Chassis SW/Whole THANG/Sabertooth2x25A.SLDPRT

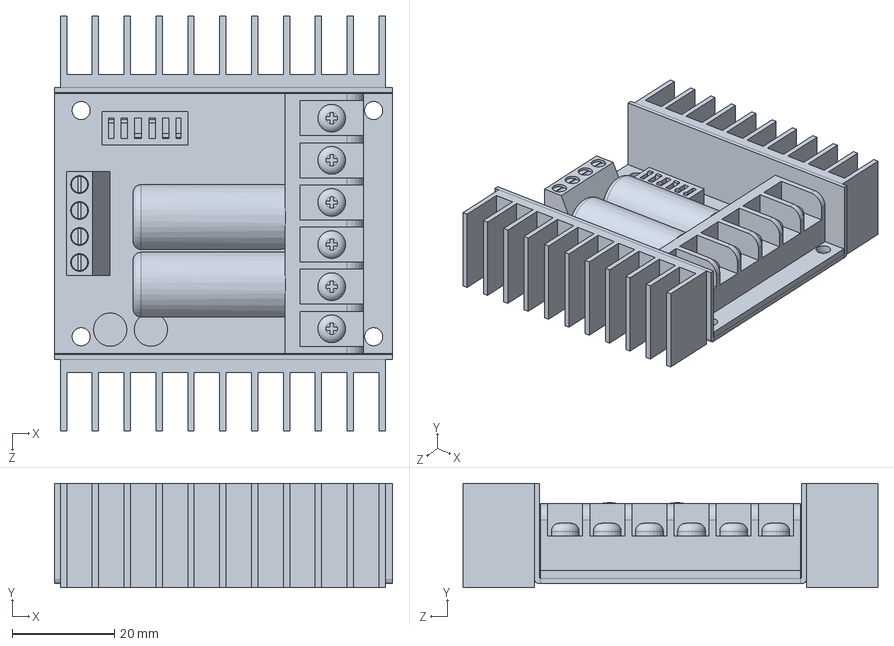
[picture p65: CAD file, 2021-12-29]
Chassis SW/Whole THANG/Sabertooth2x25A.SLDPRT
66.0 x 20.4 x 81.1 mm
