EveTheWizard/Swarm-Drones/(list of files, cad)

Other CAD files:
Chassis SW/motor_asm.SLDASM
Chassis SW/left_wheel_asm.SLDASM
Chassis SW/Whole THANG/left_wheel_asm.SLDASM
Chassis SW/Whole THANG/right_wheel_asm.SLDASM
Prints/Sabertooth Housing.SLDPRT
Chassis SW/wheel_chassis_long.SLDPRT
Prints/Pixhawk Housing - Copy.SLDPRT.STL
Chassis SW/frame_connector.SLDPRT
Chassis SW/Whole THANG/3DR Stand.SLDPRT
Drawings/Solidworks/Chasis Spacer.SLDPRT
Chassis SW/Whole THANG/motor_bracket.SLDPRT
Chassis SW/Whole THANG/small_chassis.SLDPRT
Chassis SW/Whole THANG/top_chasis.SLDPRT
Chassis SW/Whole THANG/Pixhawk Housing.SLDPRT
Chassis SW/Whole THANG/Tire.SLDPRT
Chassis SW/wheel_chassis_short.SLDPRT
Chassis SW/Whole THANG/AL-GA25 - motor.SLDPRT
Chassis SW/Whole THANG/motor_case_cover.SLDPRT
Chassis SW/Whole THANG/wheel_adapter.SLDPRT
Chassis SW/Whole THANG/3DR Platform.SLDPRT
Chassis SW/Whole THANG/Sabertooth Housing.SLDPRT
Chassis SW/Whole THANG/tire_rim.SLDPRT
Chassis SW/Whole THANG/m2_6mm_screw.SLDPRT
Chassis SW/Whole THANG/m3_8mm_allen.SLDPRT
Chassis SW/Whole THANG/m4_12mm_allen.SLDPRT
Chassis SW/Whole THANG/m4_18mm_screw.SLDPRT
Chassis SW/Whole THANG/m4_28mm_distance.SLDPRT
Chassis SW/Whole THANG/m4_nut.SLDPRT
Chassis SW/m2_6mm_screw.SLDPRT
Chassis SW/m3_8mm_allen.SLDPRT
Chassis SW/m4_12mm_allen.SLDPRT
Chassis SW/m4_18mm_screw.SLDPRT
Chassis SW/m4_28mm_distance.SLDPRT
Chassis SW/m4_nut.SLDPRT
Prints/3DR Platform.STL
Prints/3DR Stand.STL
Prints/Sabertooth Housing.STL
