EveTheWizard/Swarm-Drones/Drawings/Rover Assembly (Labels)-1.png

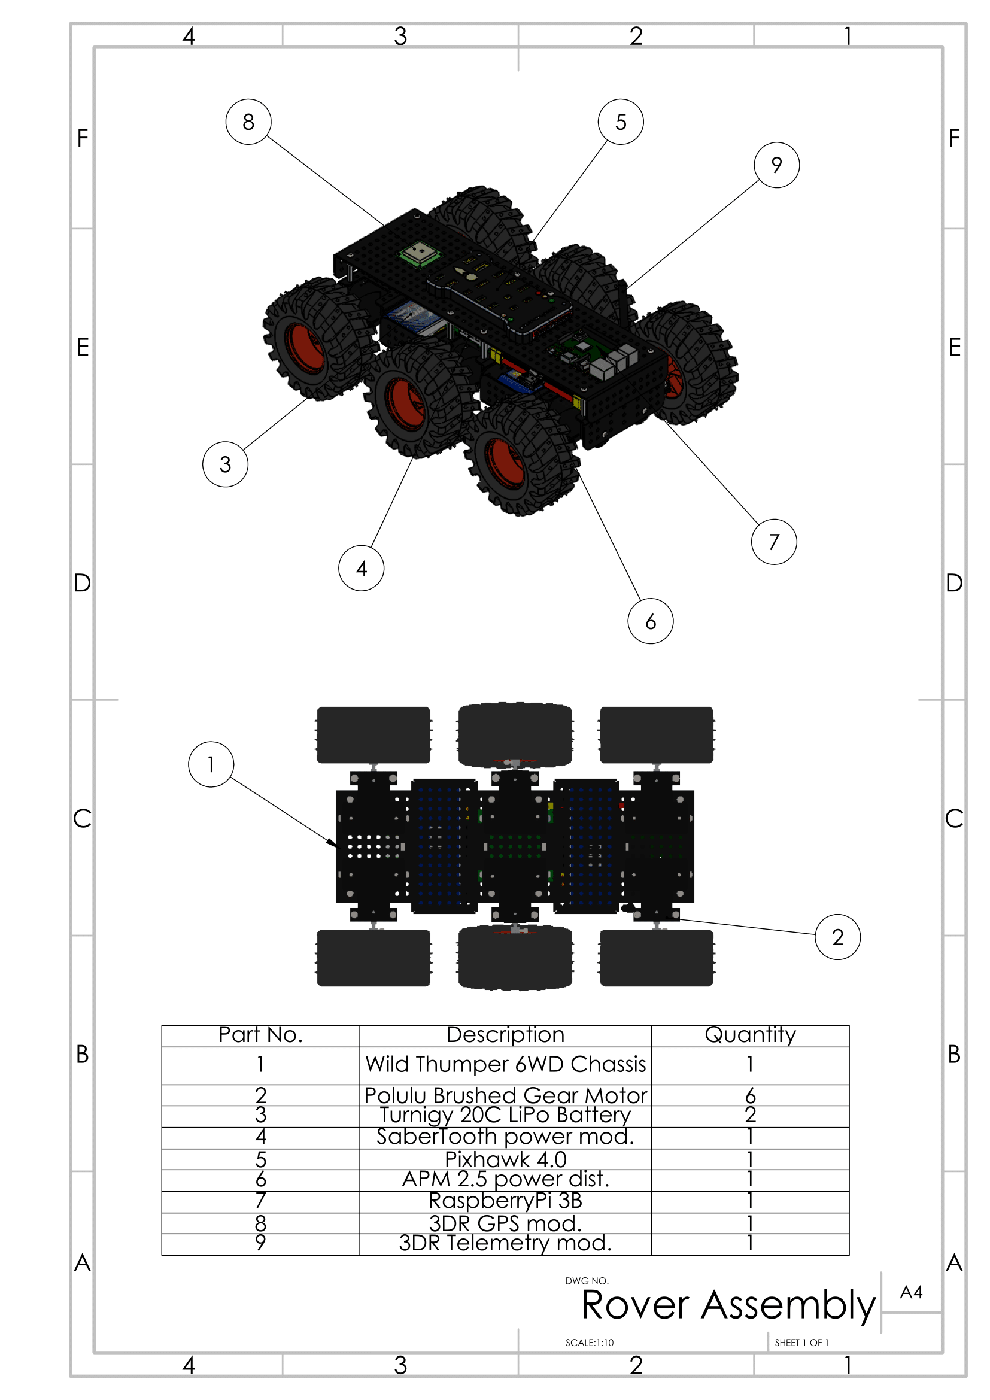
Drawings/Rover Assembly (Labels)-1.png
