EveTheWizard/Swarm-Drones/Drawings/Rover Assembly-1.png

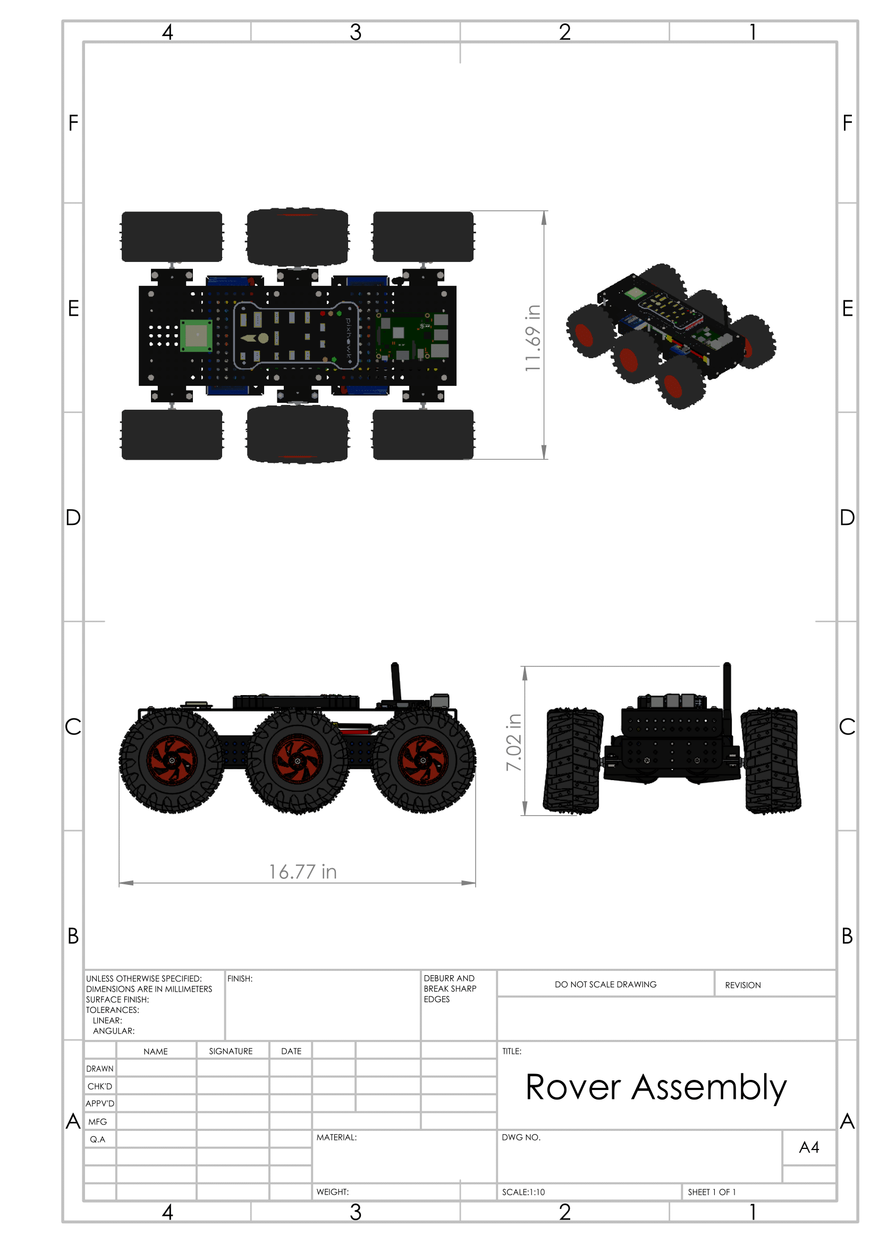
Drawings/Rover Assembly-1.png
